githubcjl/Master_Thesis/论文素材/focus1.png

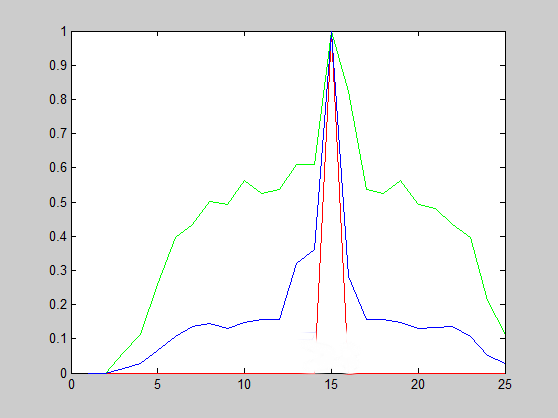
论文素材/focus1.png
