githubcjl/Master_Thesis/论文素材/IMG_0460.JPG

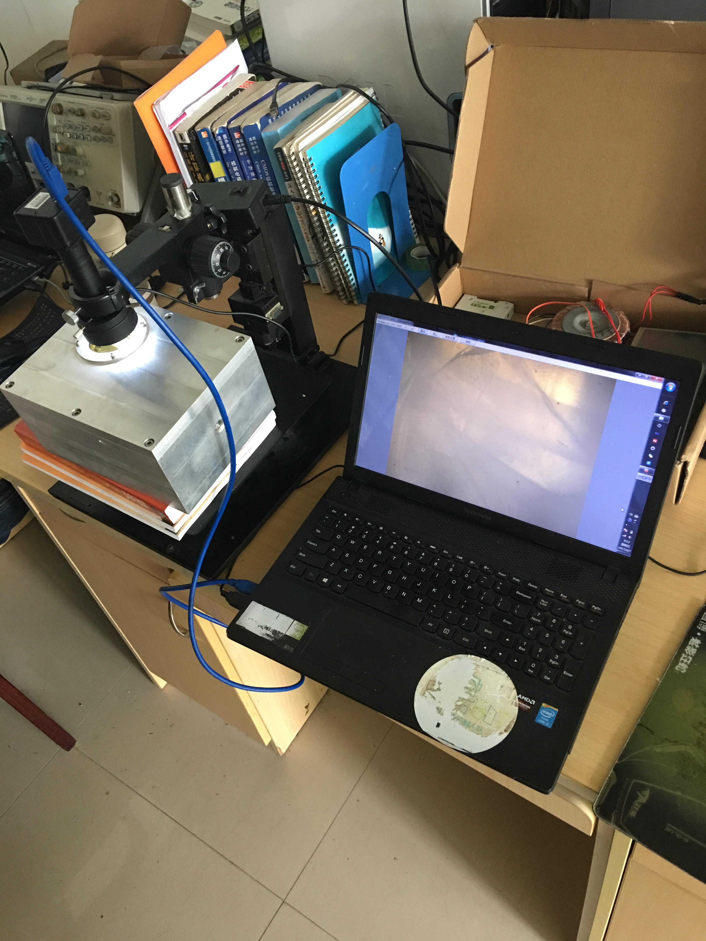
论文素材/IMG_0460.JPG
