githubcjl/Master_Thesis/论文素材/IMG_0461.JPG

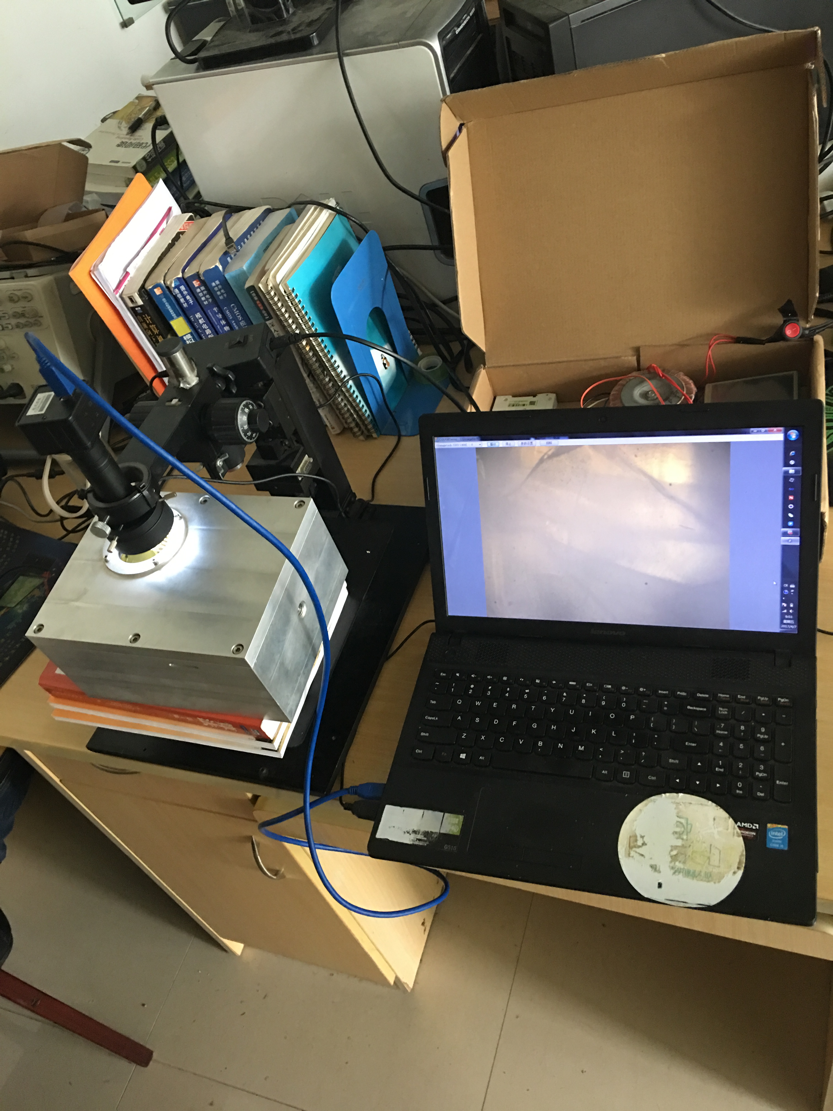
论文素材/IMG_0461.JPG
