githubcjl/Master_Thesis/论文素材/IMG_0463.JPG

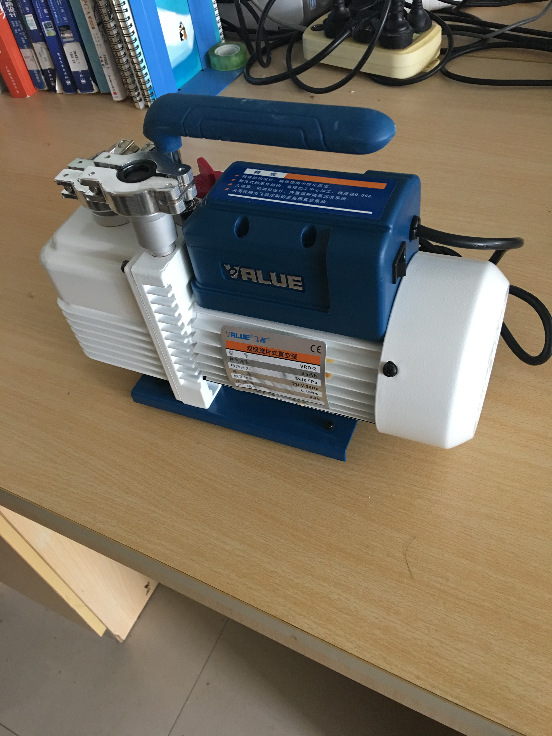
论文素材/IMG_0463.JPG
