githubcjl/Master_Thesis/论文素材/IMG_0464.JPG

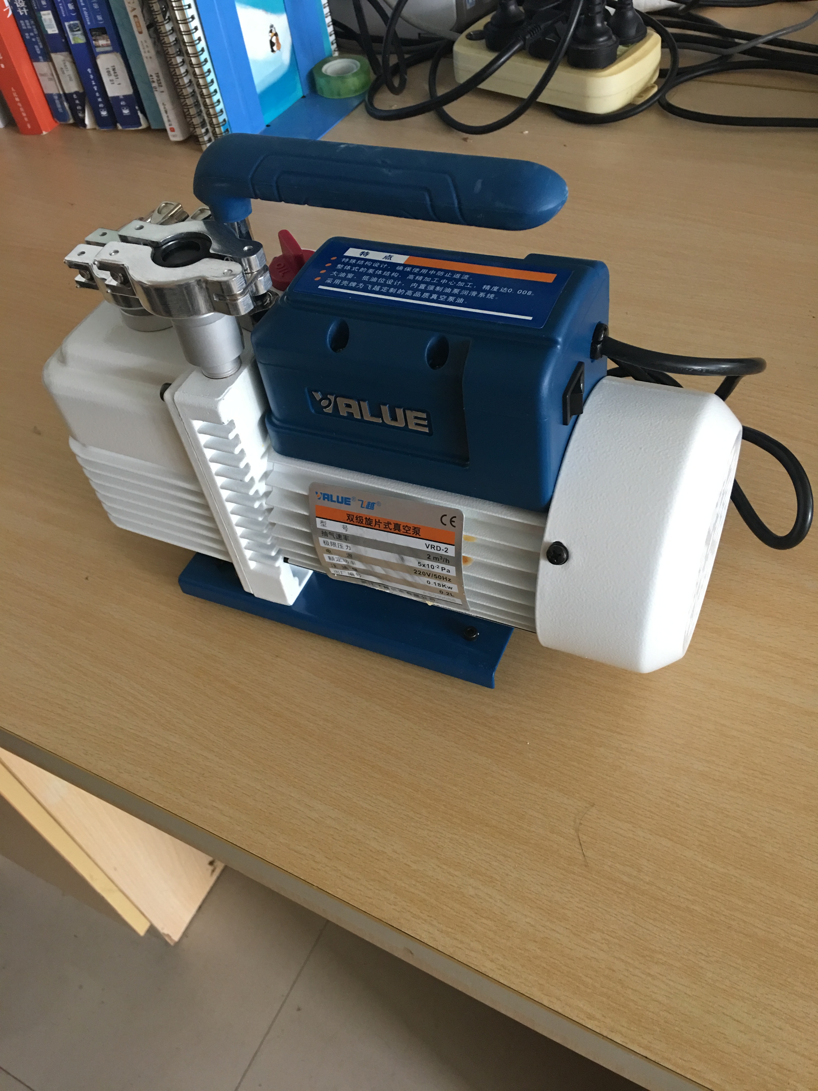
论文素材/IMG_0464.JPG
