githubcjl/Master_Thesis/论文素材/uCVD显微成像主界面.jpg

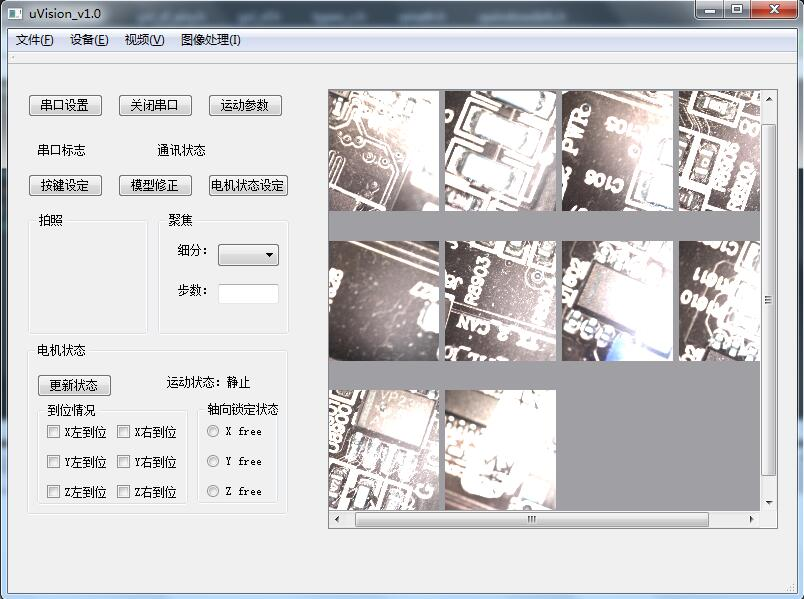
论文素材/uCVD显微成像主界面.jpg
