githubcjl/Master_Thesis/论文素材/uCVD芯片（第二版）.png

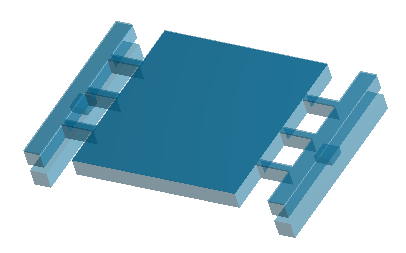
论文素材/uCVD芯片（第二版）.png
