githubcjl/Master_Thesis/论文素材/伯克利石墨烯温度分布.jpg

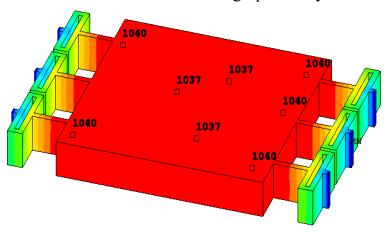
论文素材/伯克利石墨烯温度分布.jpg
