githubcjl/Master_Thesis/论文素材/供电电路1.jpg

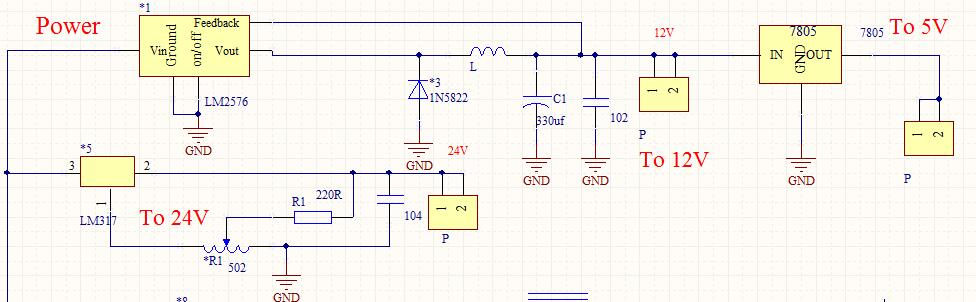
论文素材/供电电路1.jpg
