githubcjl/Master_Thesis/论文素材/单片机开发板.jpg

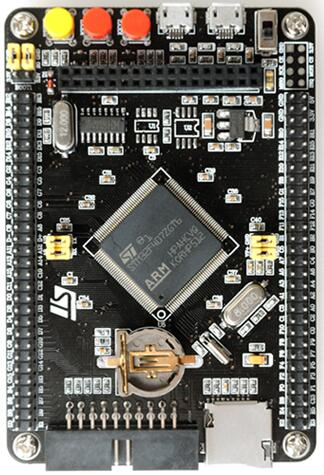
论文素材/单片机开发板.jpg
