githubcjl/Master_Thesis/论文素材/图像拼接全景图.jpg

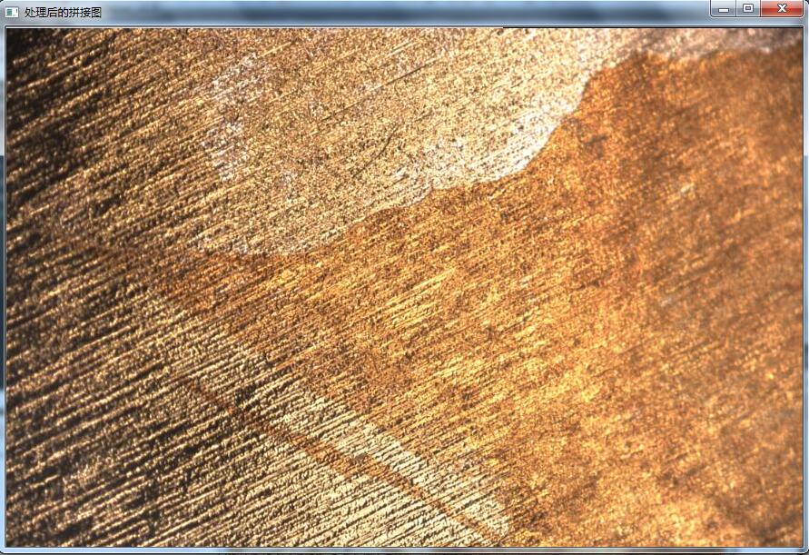
论文素材/图像拼接全景图.jpg
