githubcjl/Master_Thesis/论文素材/图像拼接右图.jpg

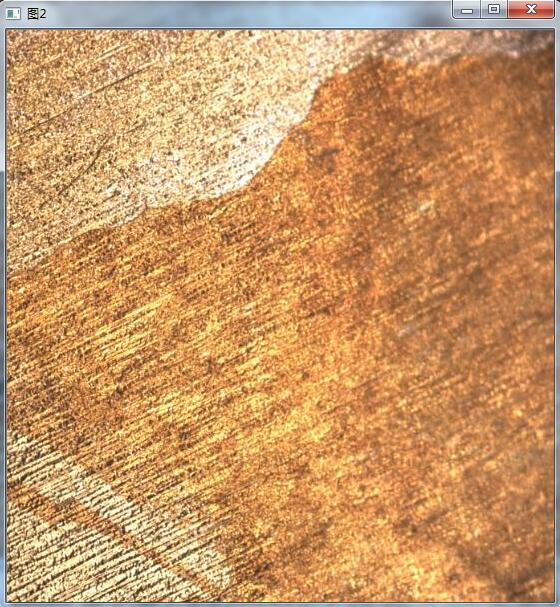
论文素材/图像拼接右图.jpg
