githubcjl/Master_Thesis/论文素材/图像采集.jpg

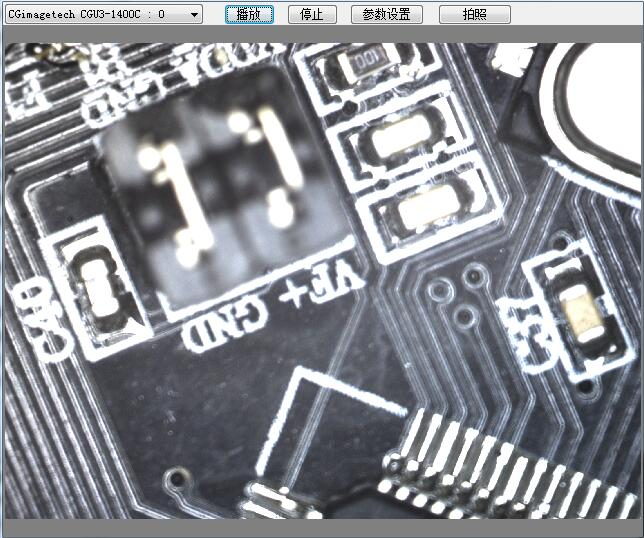
论文素材/图像采集.jpg
