githubcjl/Master_Thesis/论文素材/场效应管示意图.jpg

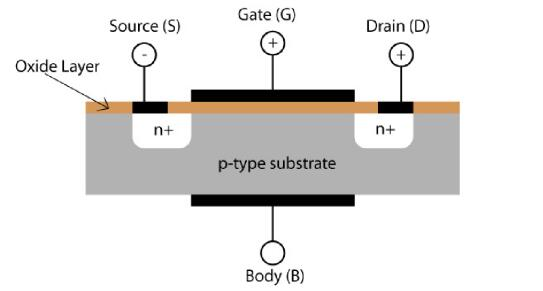
论文素材/场效应管示意图.jpg
