githubcjl/Master_Thesis/论文素材/显微成像软件图像拼接界面.jpg

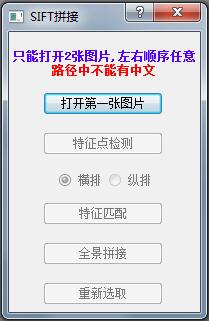
论文素材/显微成像软件图像拼接界面.jpg
