githubcjl/Master_Thesis/论文素材/显微成像软件系统设置.jpg

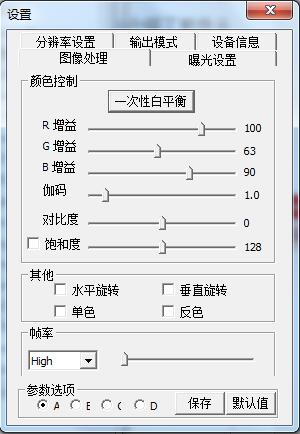
论文素材/显微成像软件系统设置.jpg
