githubcjl/Master_Thesis/论文素材/显微采集石墨烯.jpg

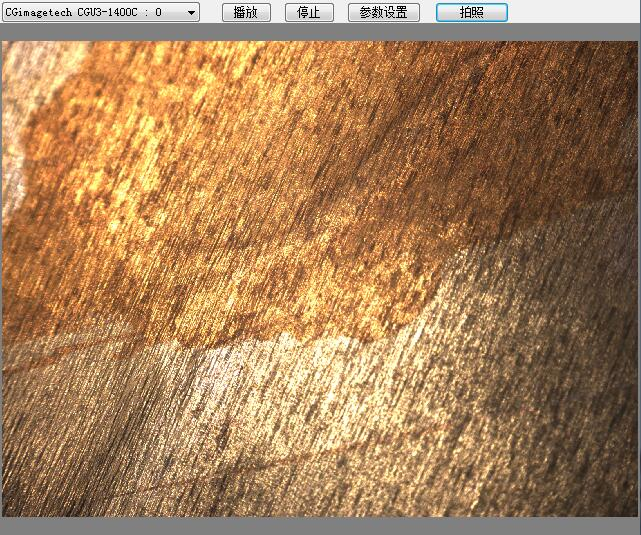
论文素材/显微采集石墨烯.jpg
