githubcjl/Master_Thesis/论文素材/桥式整流电路.jpg

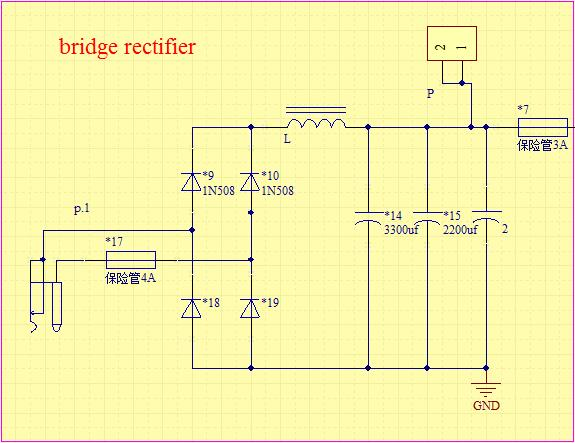
论文素材/桥式整流电路.jpg
