githubcjl/Master_Thesis/论文素材/模糊库.png

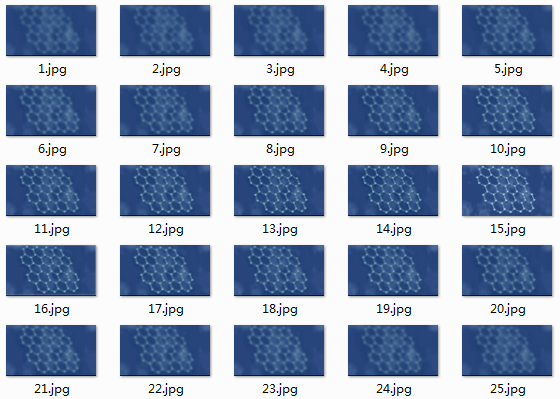
论文素材/模糊库.png
