githubcjl/Master_Thesis/论文素材/测温方法.bmp

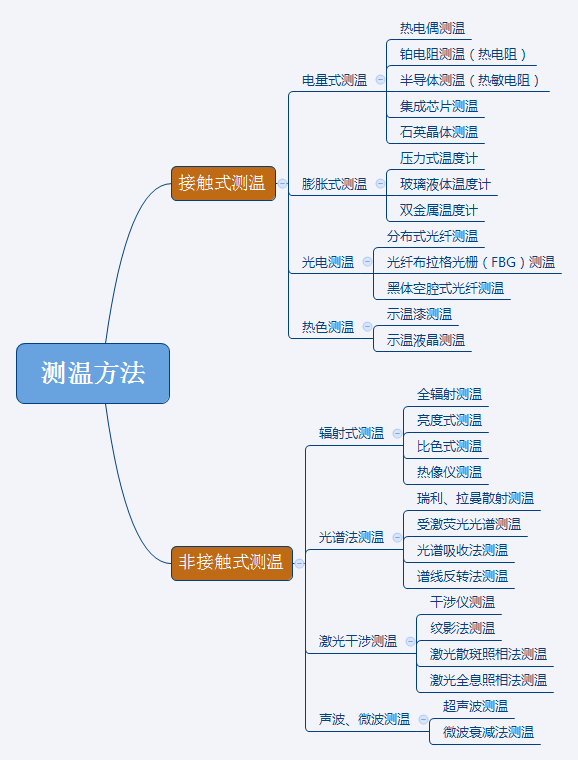
论文素材/测温方法.bmp
