githubcjl/Master_Thesis/论文素材/温度控制电路.jpg

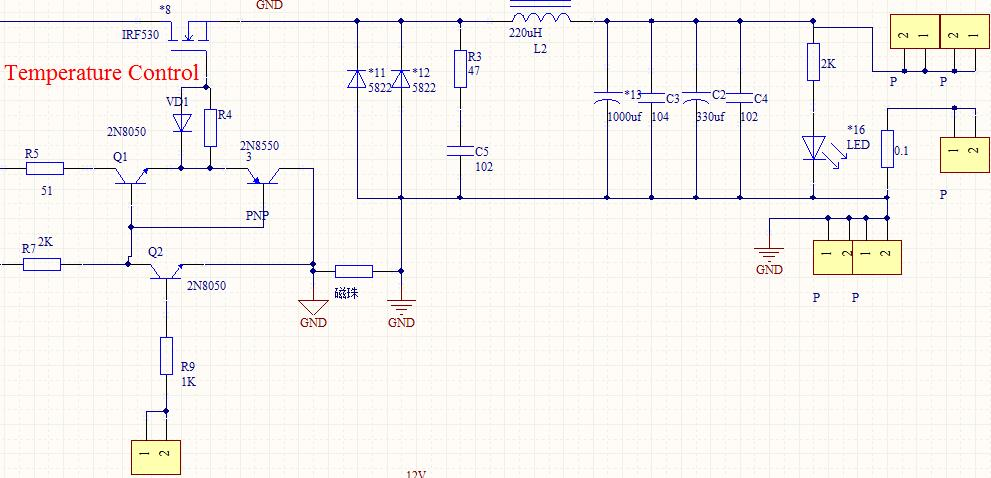
论文素材/温度控制电路.jpg
