githubcjl/Master_Thesis/论文素材/温度校准实验2.png

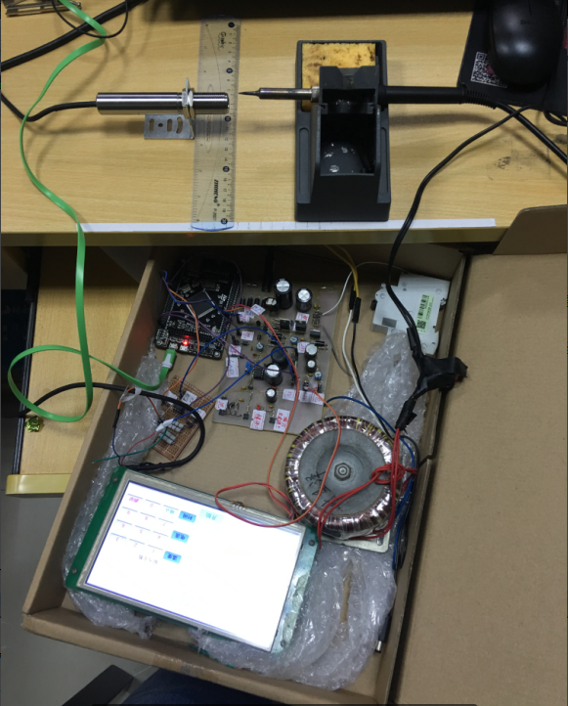
论文素材/温度校准实验2.png
