githubcjl/Master_Thesis/论文素材/温控实物.jpg

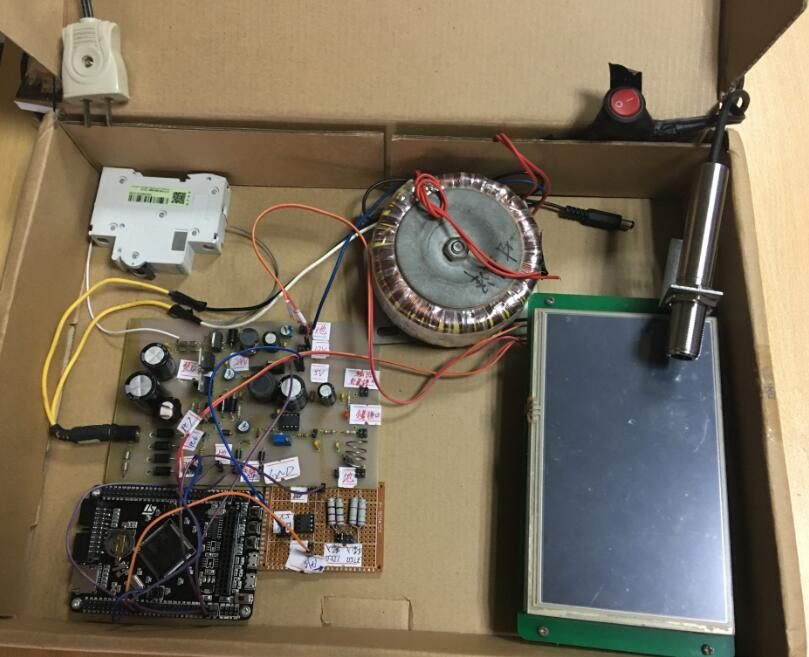
论文素材/温控实物.jpg
