githubcjl/Master_Thesis/论文素材/温控实物图.JPG

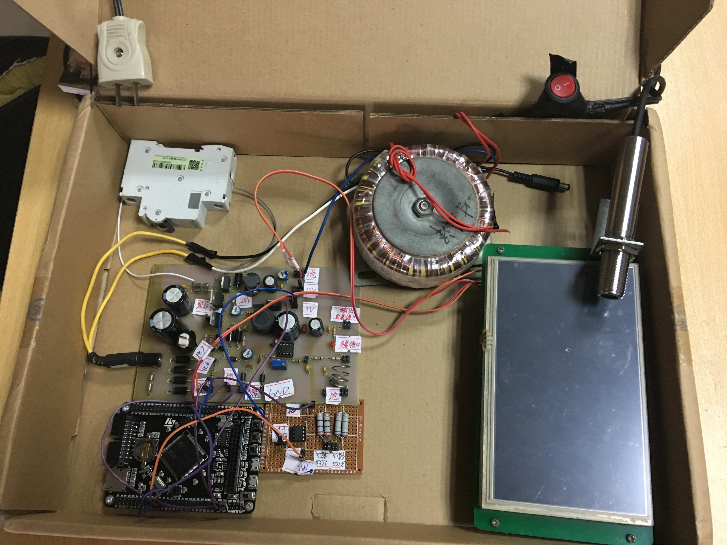
论文素材/温控实物图.JPG
