githubcjl/Master_Thesis/论文素材/电子目镜实物.JPG

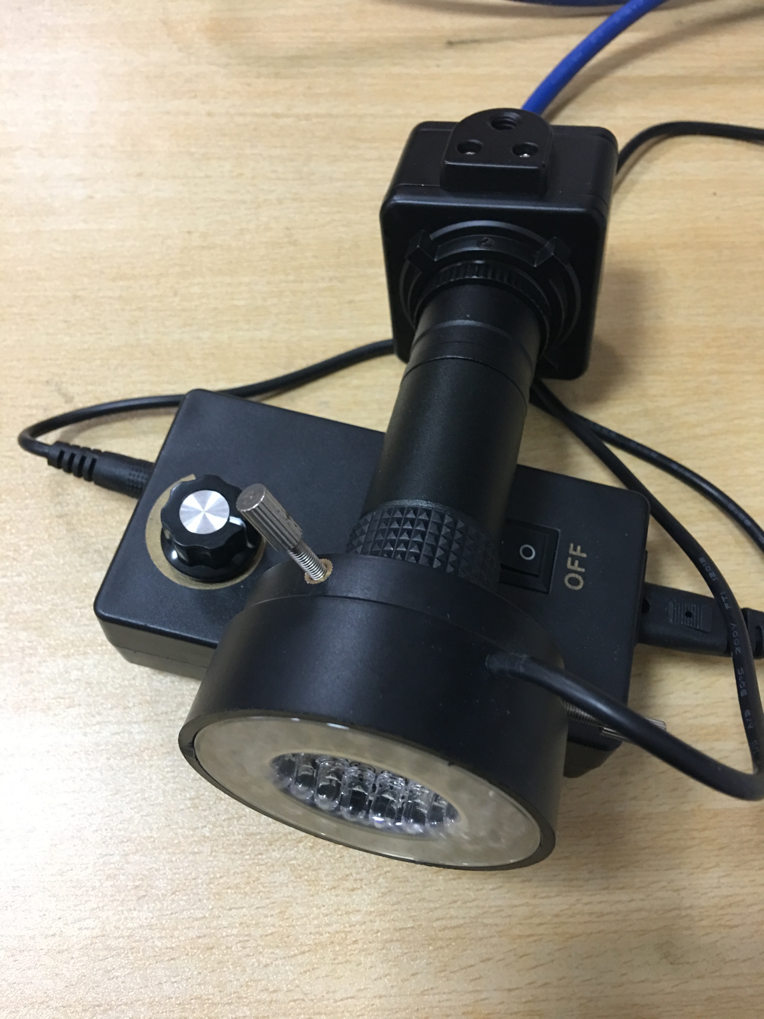
论文素材/电子目镜实物.JPG
