githubcjl/Master_Thesis/论文素材/电子目镜实验台爆炸视图.png

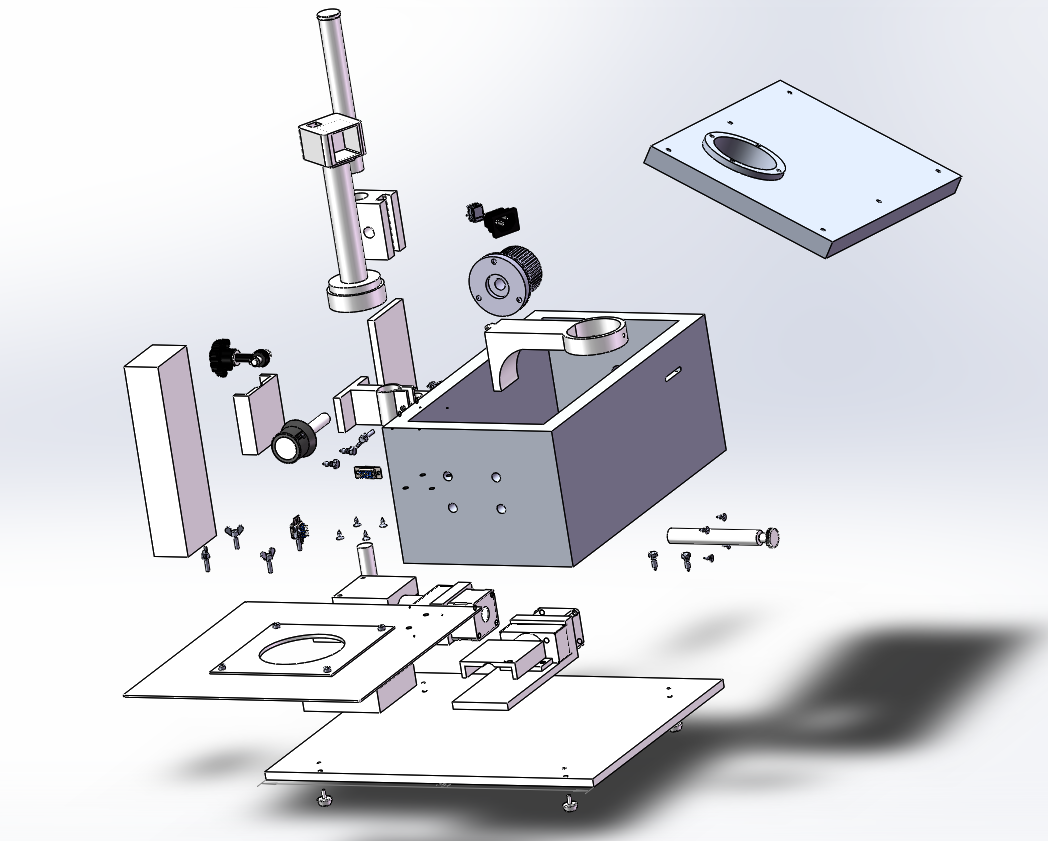
论文素材/电子目镜实验台爆炸视图.png
