githubcjl/Master_Thesis/论文素材/电机基座正视图.png

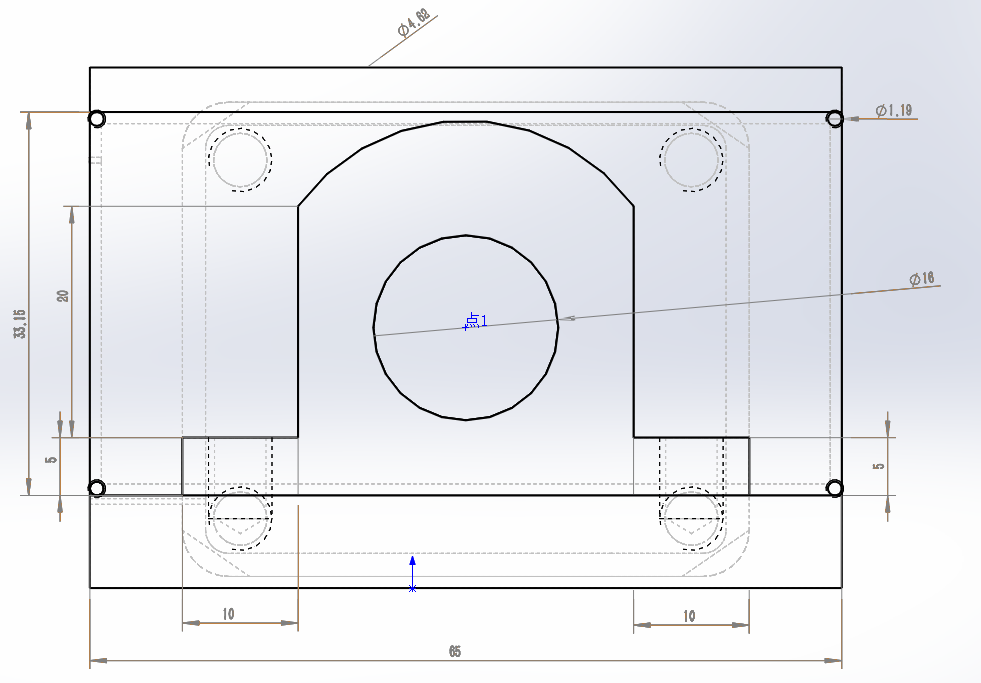
论文素材/电机基座正视图.png
