githubcjl/Master_Thesis/论文素材/石墨烯三维能带图.jpg

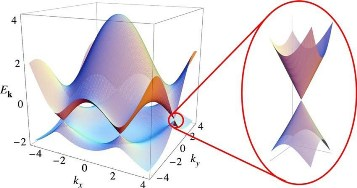
论文素材/石墨烯三维能带图.jpg
