githubcjl/Master_Thesis/论文素材/第一版uCVD.png

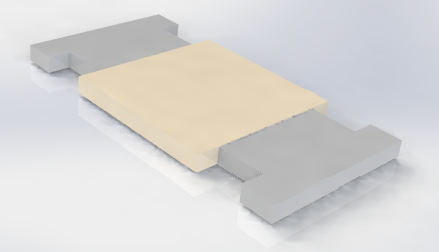
论文素材/第一版uCVD.png
