githubcjl/Master_Thesis/论文素材/第二版芯片温度仿真.png

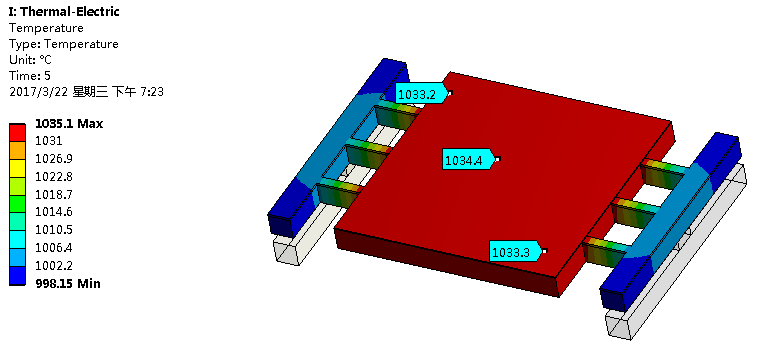
论文素材/第二版芯片温度仿真.png
