githubcjl/Master_Thesis/论文素材/红外测温仪.jpg

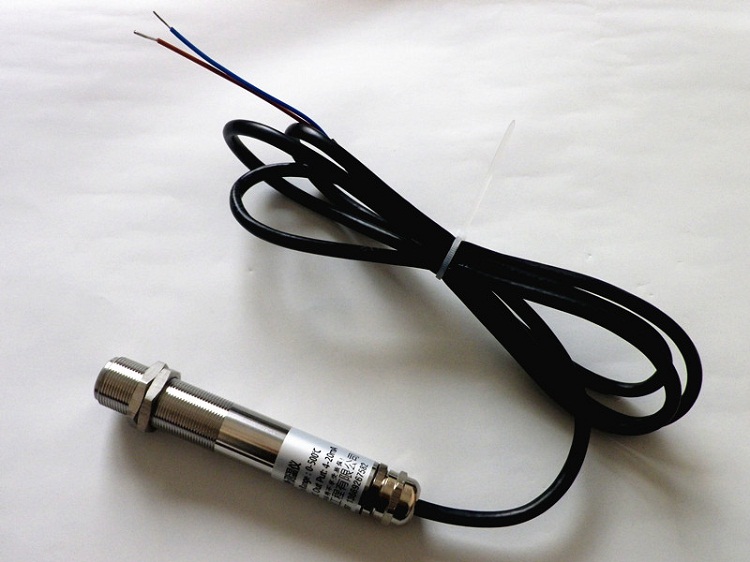
论文素材/红外测温仪.jpg
