githubcjl/Master_Thesis/论文素材/黑体辐射曲线.jpg

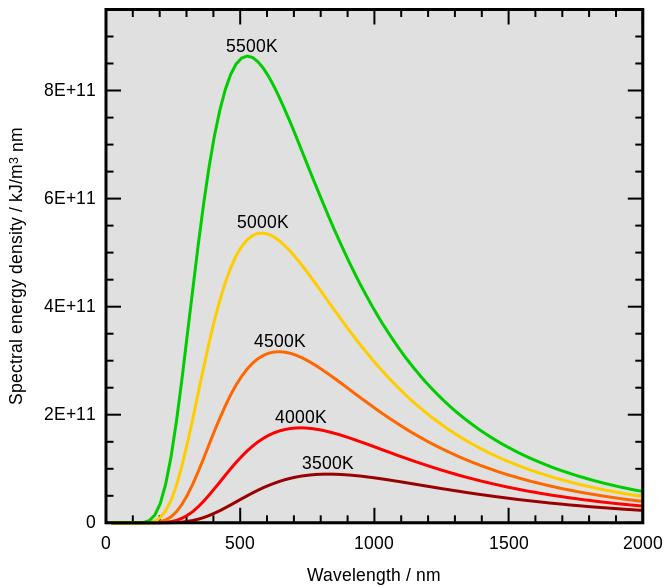
论文素材/黑体辐射曲线.jpg
