githubcjl/Master_Thesis/论文素材/uCVD系统装配/装配体1.SLDASM

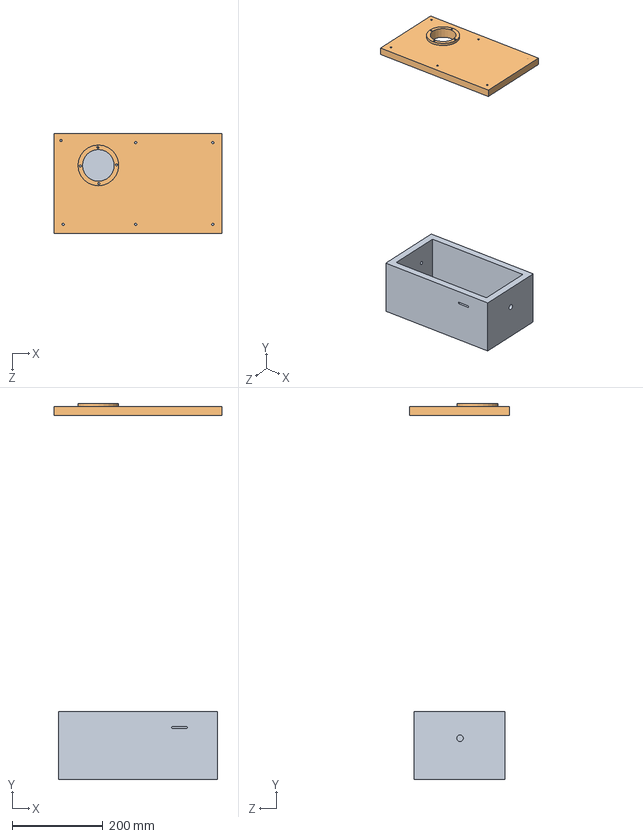
[picture p41: CAD file, 2017-04-08]
论文素材/uCVD系统装配/装配体1.SLDASM
370.0 x 829.8 x 220.0 mm
腔体
腔体盖子
