githubcjl/Master_Thesis/论文素材/uCVD系统装配/uCVD系统.SLDASM

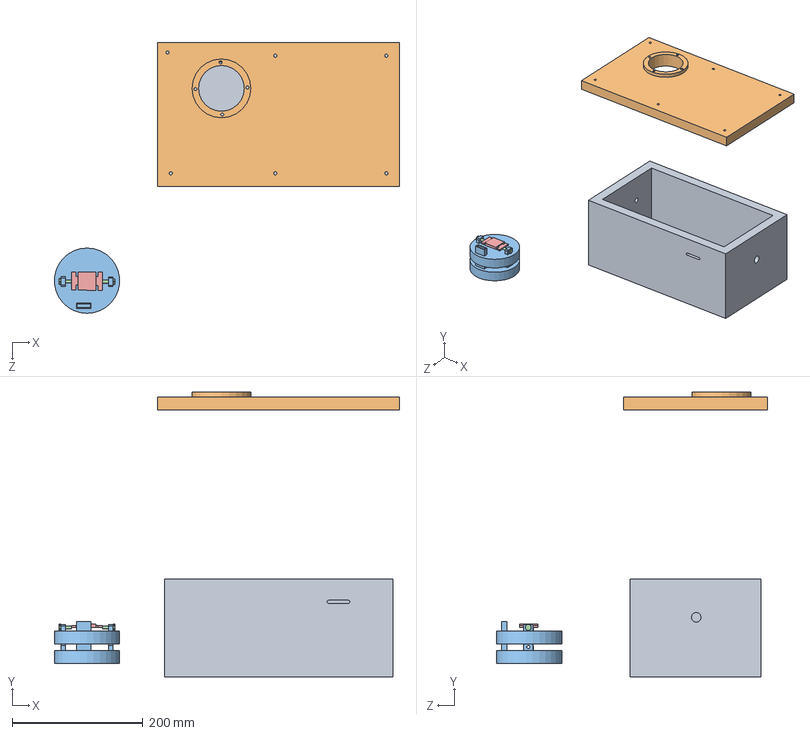
[picture p42: CAD file, 2017-04-08]
论文素材/uCVD系统装配/uCVD系统.SLDASM
528.0 x 435.6 x 414.3 mm
腔体
腔体盖子
升降台 x 2
升降台螺丝 x 2
uCVD芯片
