githubcjl/Master_Thesis/论文素材/uCVD系统装配/升降台螺丝.SLDPRT

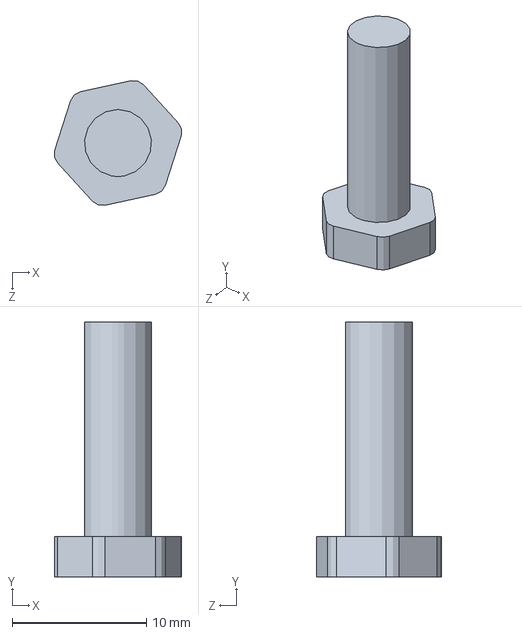
[picture p43: CAD file, 2017-04-08]
论文素材/uCVD系统装配/升降台螺丝.SLDPRT
9.47 x 19.0 x 9.28 mm
