githubcjl/Master_Thesis/论文素材/uCVD系统装配/腔体.SLDPRT

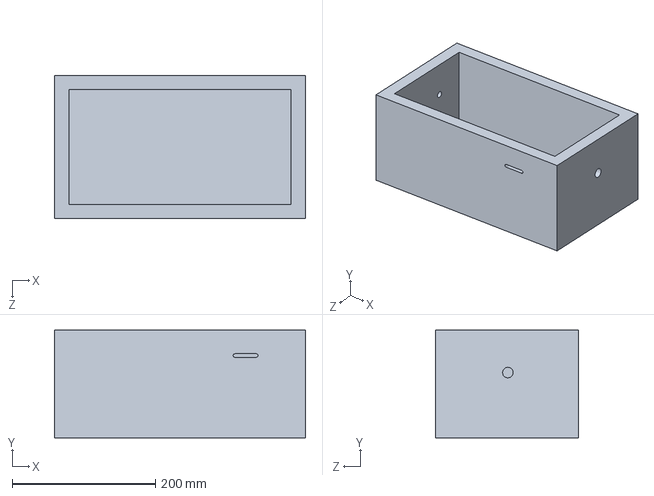
[picture p44: CAD file, 2017-04-08]
论文素材/uCVD系统装配/腔体.SLDPRT
350.0 x 150.0 x 200.0 mm
