githubcjl/Master_Thesis/论文素材/uCVD系统装配/升降台.SLDPRT

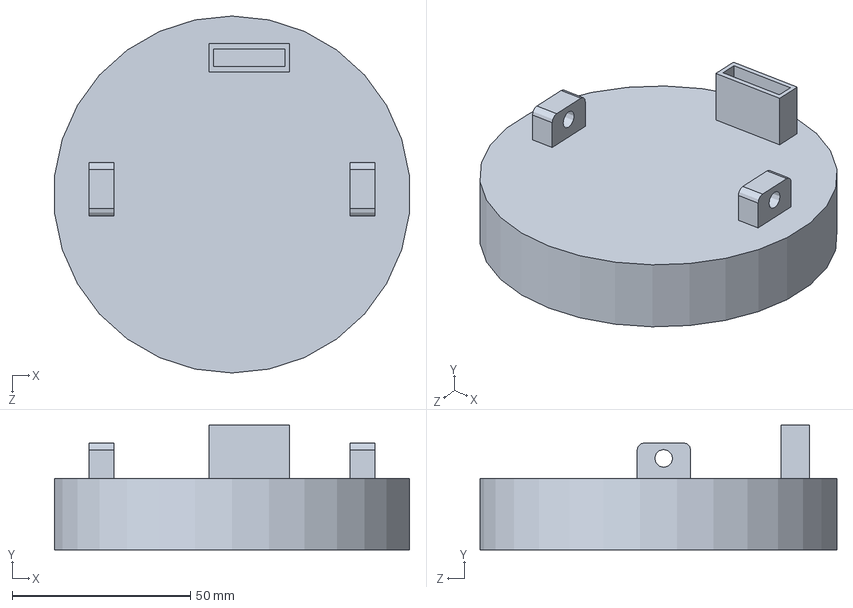
[picture p45: CAD file, 2017-04-08]
论文素材/uCVD系统装配/升降台.SLDPRT
99.5 x 35.0 x 100.0 mm
