githubcjl/Master_Thesis/论文素材/uCVD系统装配/腔体盖子.SLDPRT

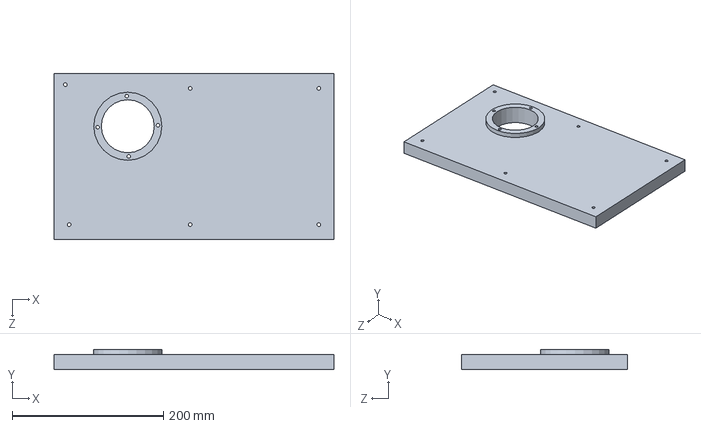
[picture p46: CAD file, 2017-04-08]
论文素材/uCVD系统装配/腔体盖子.SLDPRT
370.0 x 27.0 x 220.0 mm
