githubcjl/Master_Thesis/论文素材/uCVD系统装配/uCVD芯片.SLDPRT

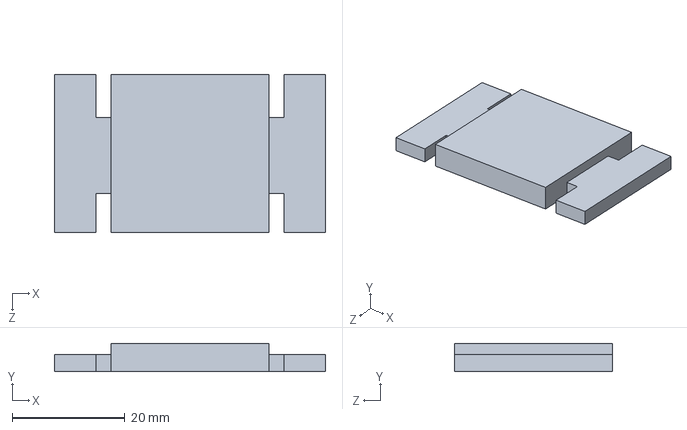
[picture p47: CAD file, 2017-04-08]
论文素材/uCVD系统装配/uCVD芯片.SLDPRT
48.0 x 5.00 x 28.0 mm
