githubcjl/Master_Thesis/论文素材/uCVD系统腔体装配.JPG

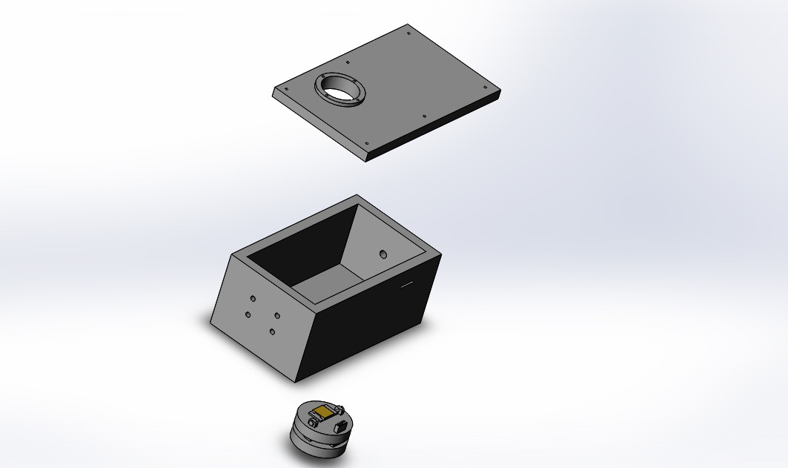
论文素材/uCVD系统腔体装配.JPG
