githubcjl/Master_Thesis/论文素材/uCVD系统装配1.JPG

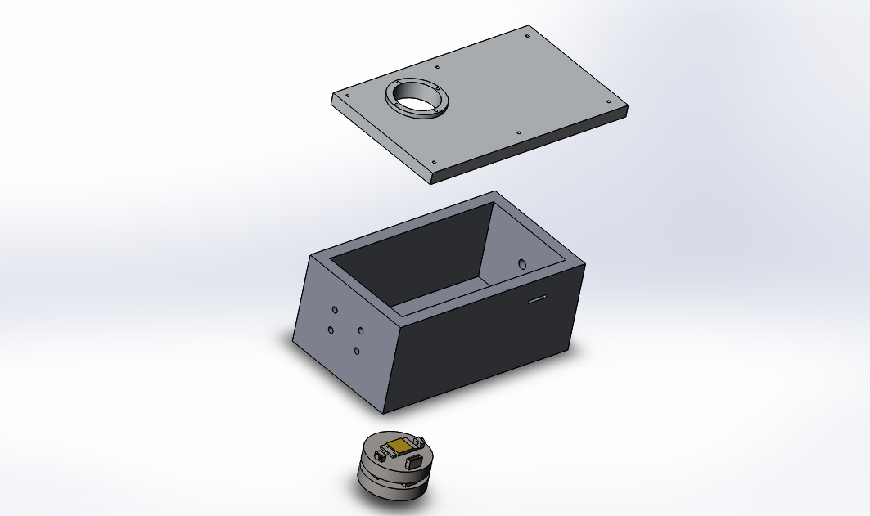
论文素材/uCVD系统装配1.JPG
