githubcjl/Master_Thesis/论文素材/uCVD系统装配/总装配图.PNG

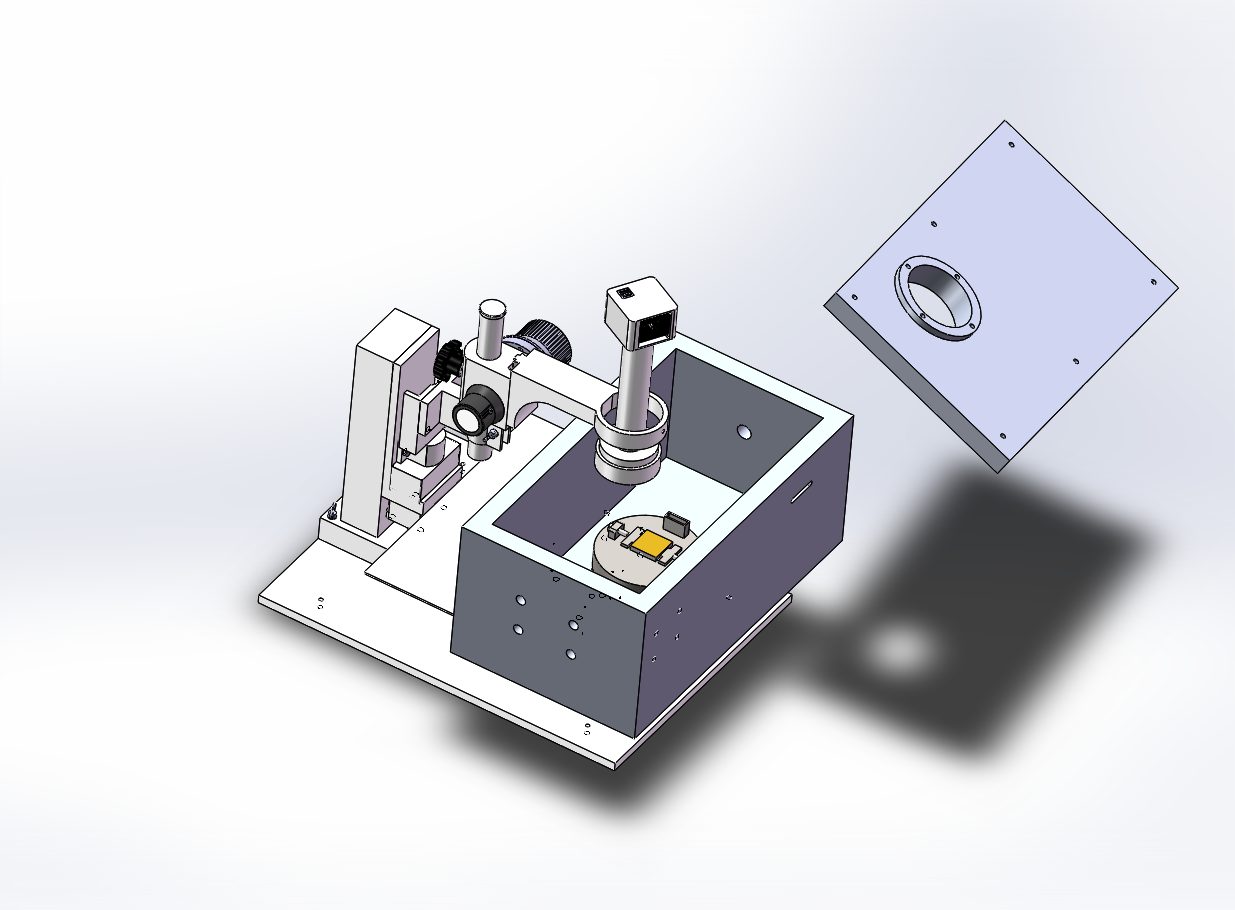
论文素材/uCVD系统装配/总装配图.PNG
