githubcjl/Master_Thesis/论文素材/uCVD系统装配/电子目镜实验台.PNG

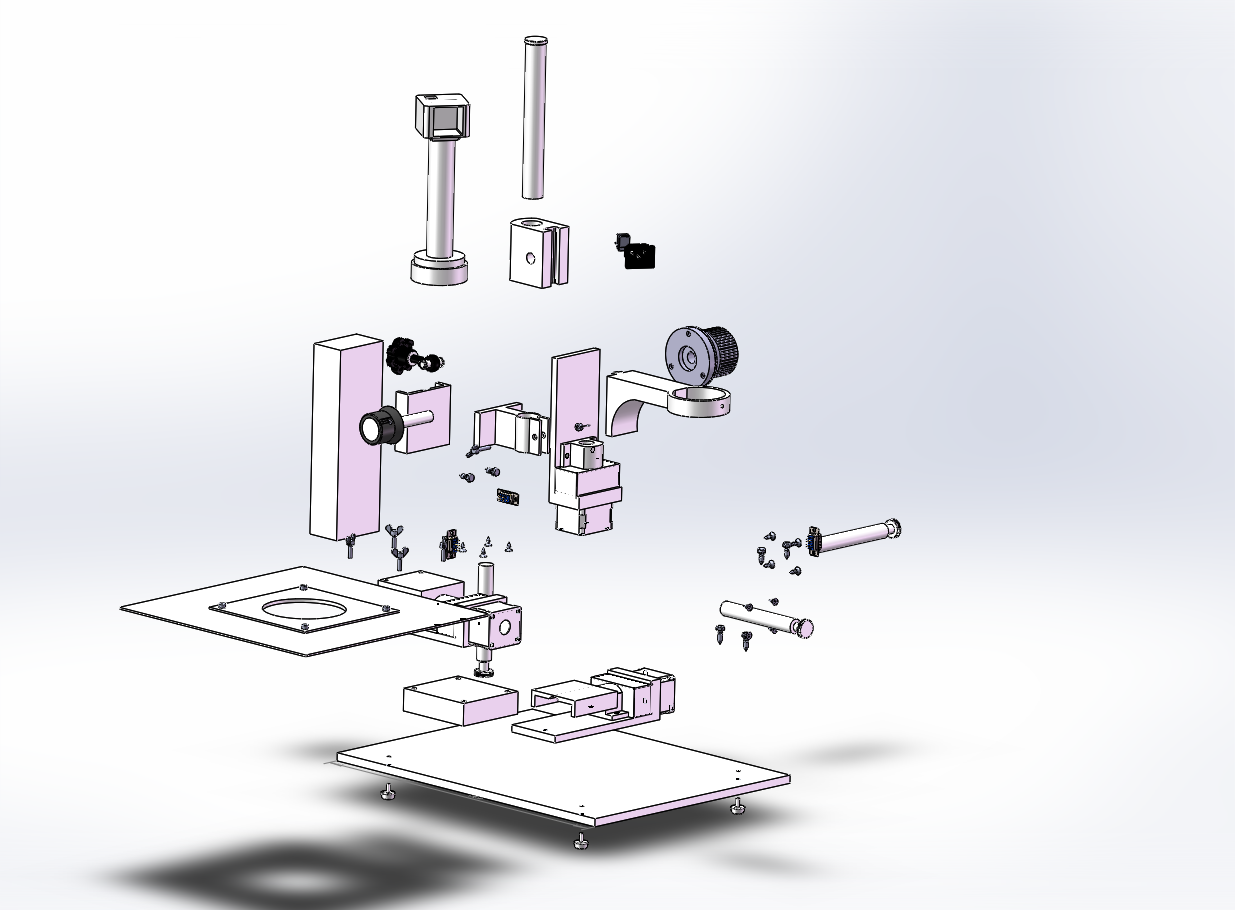
论文素材/uCVD系统装配/电子目镜实验台.PNG
