githubcjl/Master_Thesis/论文素材/uCVD系统装配/电子目镜爆炸.jpg

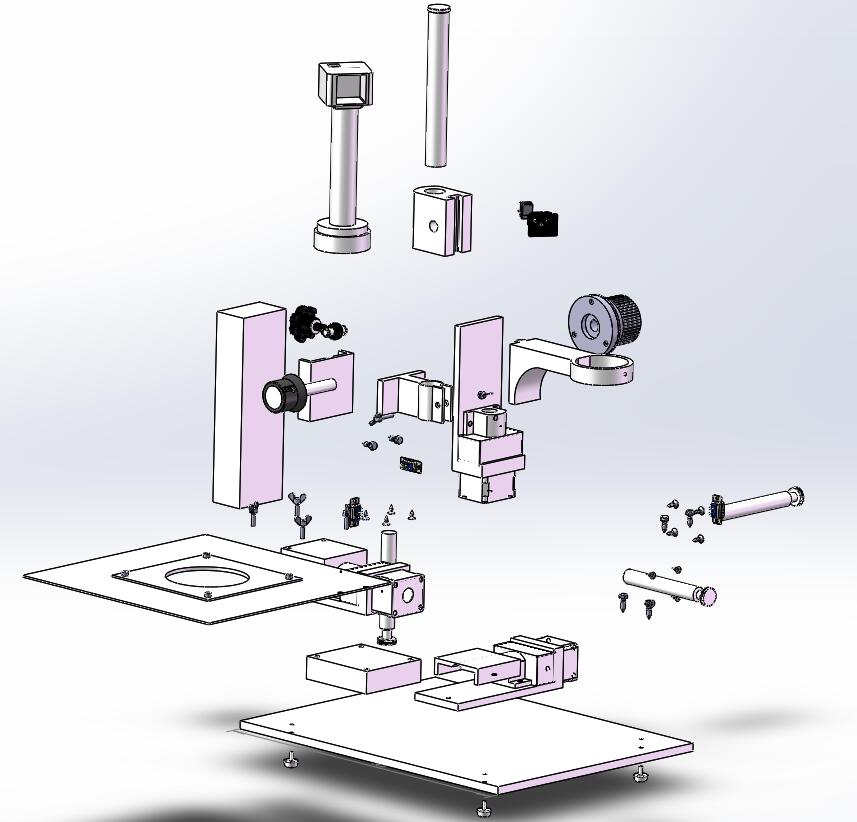
论文素材/uCVD系统装配/电子目镜爆炸.jpg
