githubcjl/Master_Thesis/(commit log)

2017-02-20 添加了芯片加工工艺文档
    上海微系统所芯片加工需求说明
2017-02-20 编辑好目录
    开始写第一章
2017-02-26 开始写第三章
    开始写第三章
2017-03-07 第四章完成
    第四章完成
2017-03-18 完成五、六章
    完成五、六章，待补充对比实验和图片表格
2017-03-19 写完六章，补充第二章图片
    写完六章，补充第二章图片
2017-03-20 修改第二章，完成第二章附图
    修改论文v2.1，修改第二章，完成第二章附图
2017-03-21 论文v2.1.修改三、四章，完成附图
    论文v2.1.修改三、四章，完成附图，缺少温控算法的matlab仿真
2017-03-22 修改论文v2.1，完成1~6章（差3副实物图）
    修改论文v2.1，完成6章（差3副实物图），还有第七章，公式部分需要修改
2017-03-24 修改论文v2.1，完成六章图表公式排版
    修改论文v2.1，完成六章图表公式排版，差3张实物图
2017-03-27 修改论文v2.1，完成第七章展望总结和致谢，差摘要
    修改论文v2.1，完成第七章展望总结和致谢，差摘要
2017-03-27 修改论文v2.1.排版，完成展望、致谢和摘要
    修改论文v2.1.排版，完成展望、致谢和摘要
2017-04-08 论文初稿完成，并提交老师
    论文初稿完成，并提交老师
    [uCVD系统.SLDASM, uCVD芯片.SLDPRT, 升降台.SLDPRT, 升降台螺丝.SLDPRT, 腔体.SLDPRT, 腔体盖子.SLDPRT, 装配体1.SLDASM]
2017-04-25 论文初稿v3.1，送审
    论文初稿v3.1，送审
